bimanamara/WaterDSlytics/Graph Design/aki.png

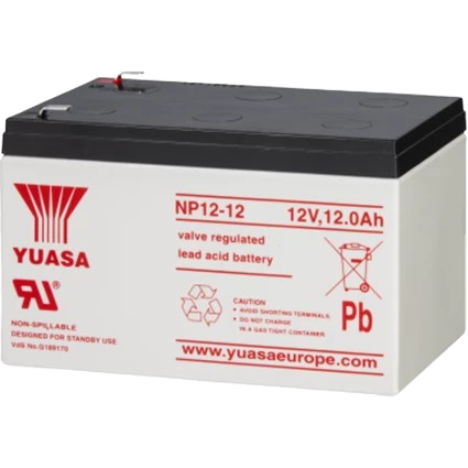
Graph Design/aki.png
