bimanamara/WaterDSlytics/Graph Design/LITHIUM ION.png

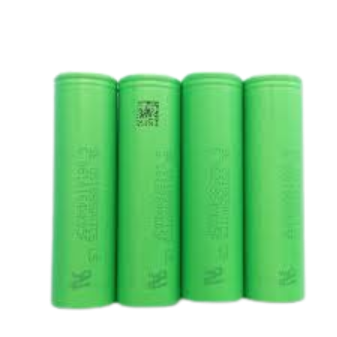
Graph Design/LITHIUM ION.png
