bimanamara/WaterDSlytics/Banner Proyek.pdf

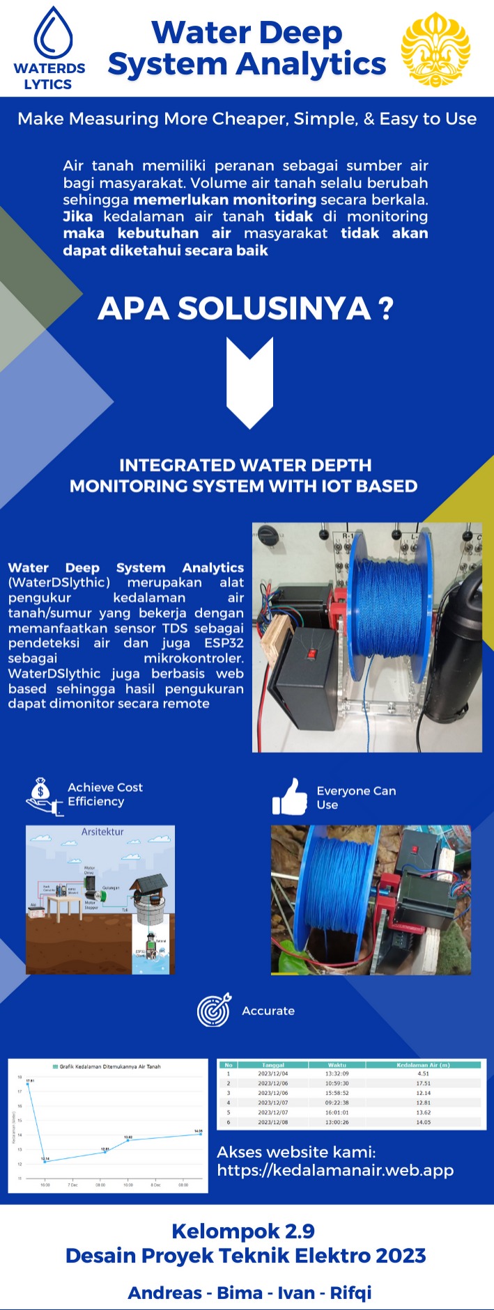
[picture p46: page 1]
