bimanamara/WaterDSlytics/Graph Design/BOTOL.png

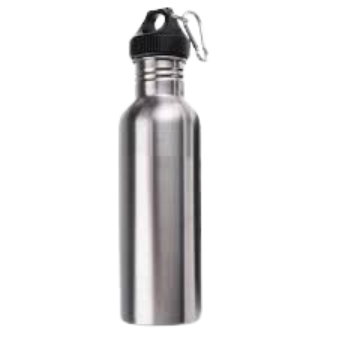
Graph Design/BOTOL.png
