bimanamara/WaterDSlytics/Graph Design/BUCK CONVERTER.png

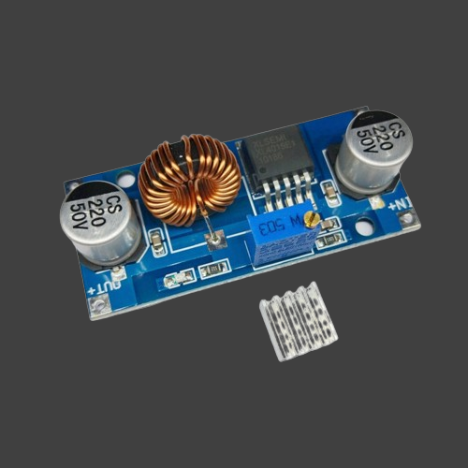
Graph Design/BUCK CONVERTER.png
