bimanamara/WaterDSlytics/Graph Design/DRIVER MOTOR STEPPER TB6600.png

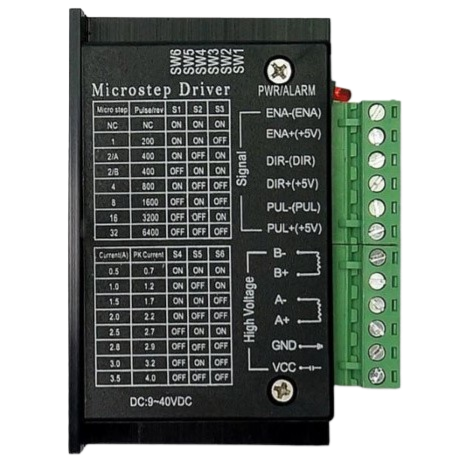
Graph Design/DRIVER MOTOR STEPPER TB6600.png
