bimanamara/WaterDSlytics/Graph Design/ESP32.png

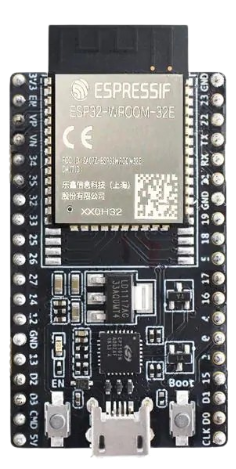
Graph Design/ESP32.png
