bimanamara/WaterDSlytics/Graph Design/flat-design-box-die-cut-template/7930025.jpg

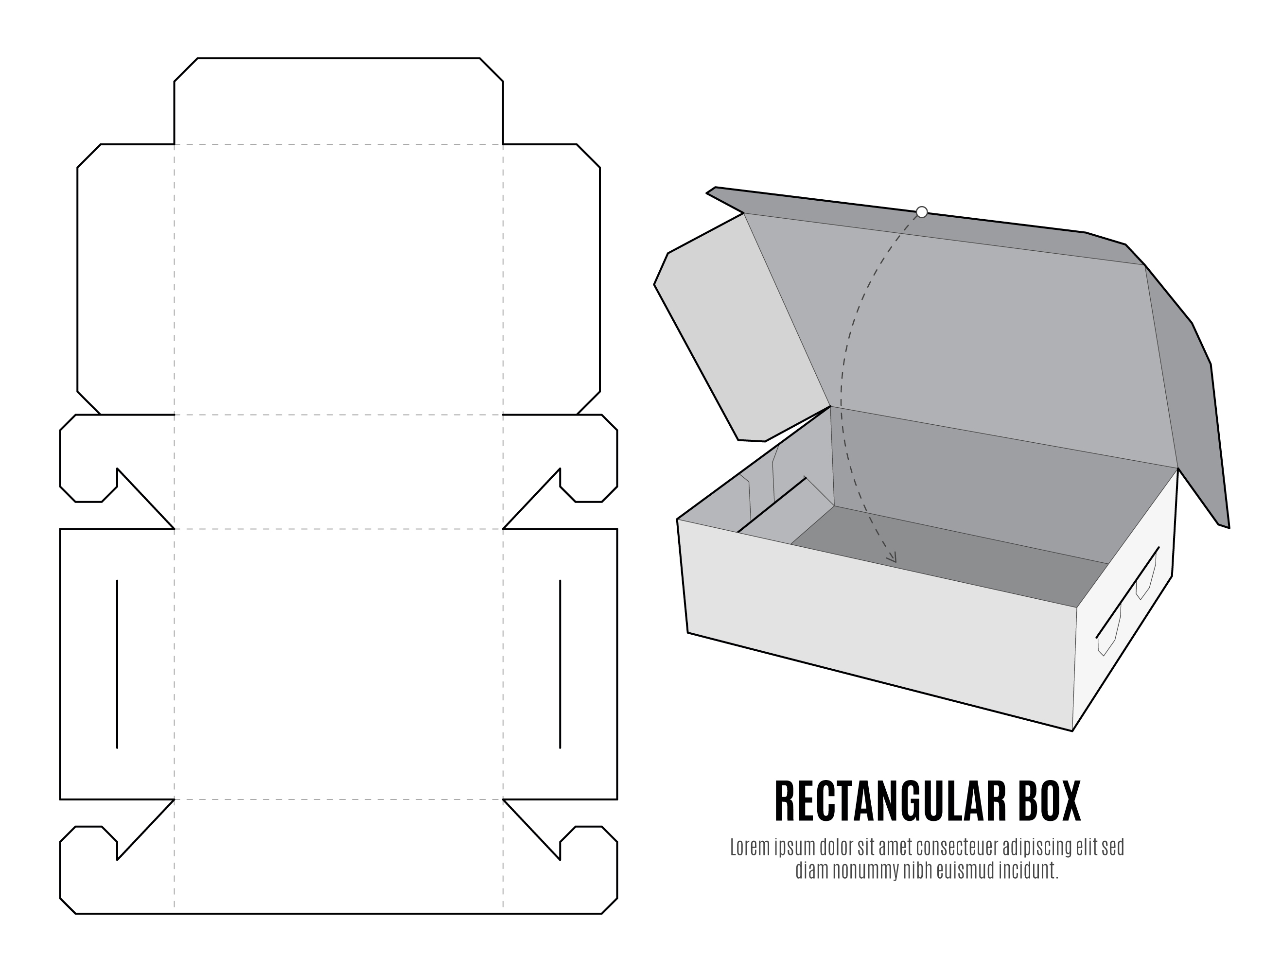
Graph Design/flat-design-box-die-cut-template/7930025.jpg
