bimanamara/WaterDSlytics/Graph Design/flat-design-world-habitat-day/4253801.jpg

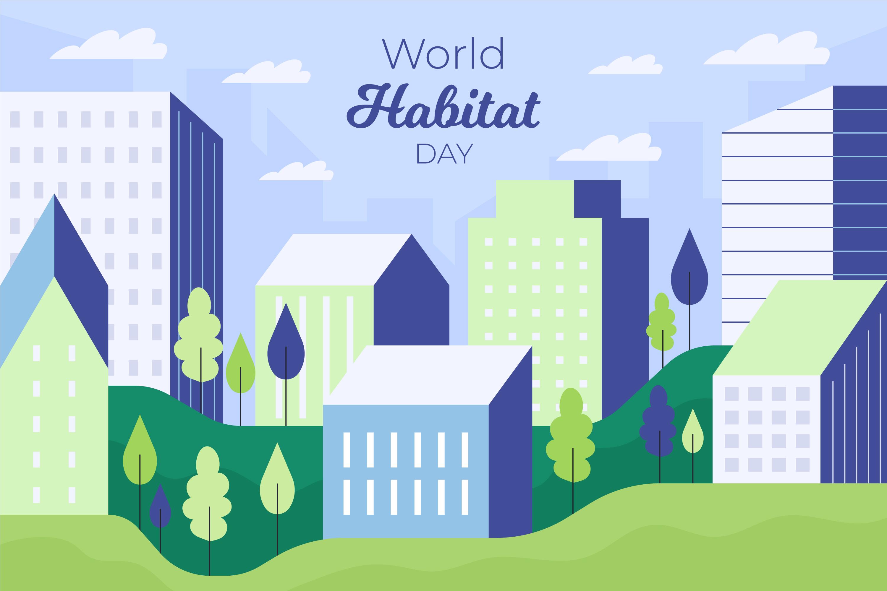
Graph Design/flat-design-world-habitat-day/4253801.jpg
