bimanamara/WaterDSlytics/Graph Design/gulungan 1.png

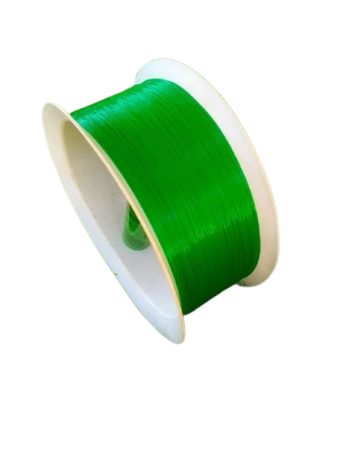
Graph Design/gulungan 1.png
