bimanamara/WaterDSlytics/Graph Design/meja kecil.png

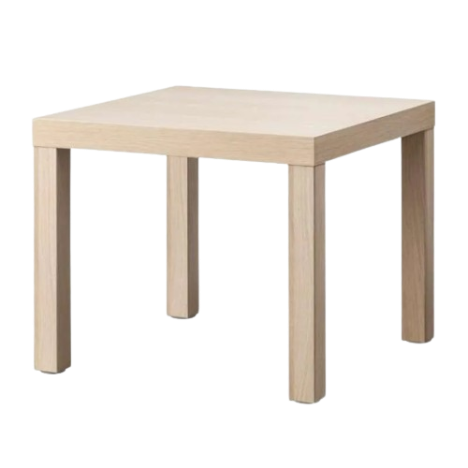
Graph Design/meja kecil.png
