bimanamara/WaterDSlytics/Graph Design/messageImage_1702189771055.jpg

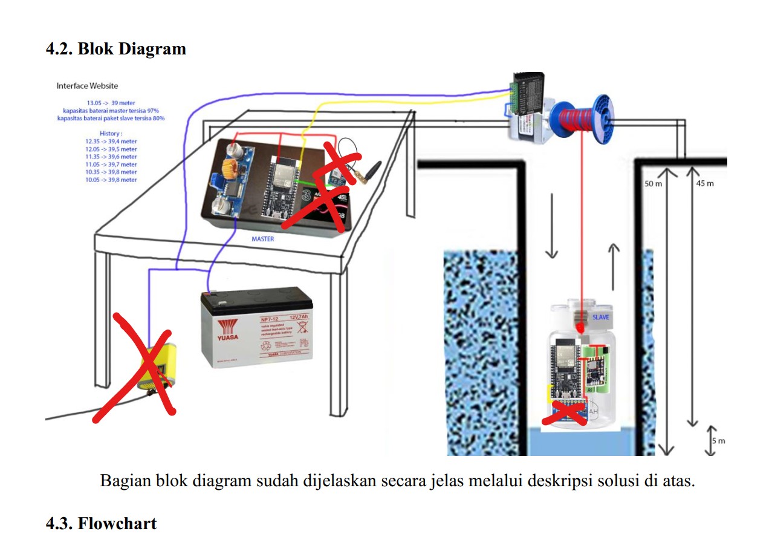
Graph Design/messageImage_1702189771055.jpg
