bimanamara/WaterDSlytics/Graph Design/MOTOR STEPPER.png

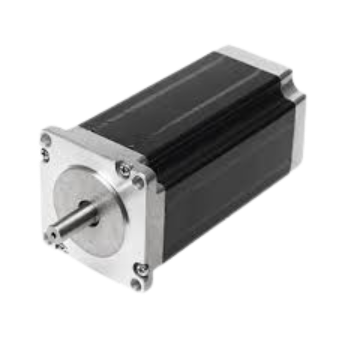
Graph Design/MOTOR STEPPER.png
