bimanamara/WaterDSlytics/Graph Design/sumur.png

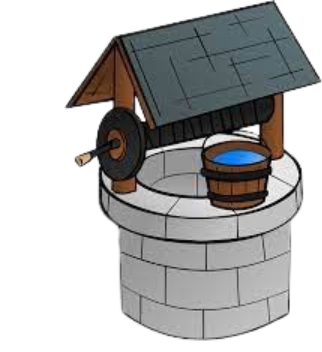
Graph Design/sumur.png
