bimanamara/WaterDSlytics/Graph Design/TDS asli.png

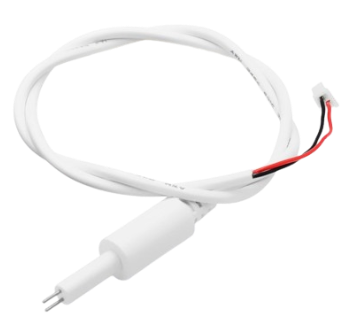
Graph Design/TDS asli.png
