bimanamara/WaterDSlytics/Kelompok 2.9_Rekap Biaya Terbaru.xlsx

LINK BUKTI LAMPIRAN REKAP TRANSAKSI : https://docs.google.com/document/d/1Jam1K2B390JuWFsyJVYhOXZ56DJ6v8_B9Y5BSTzgP9A/edit
Grup | Nomor | Item | Tanggal Pembelian | Bukti Pembayaran | Total | Jumlah | Pembeli
2023-09-02 | 1 | Kartu Perdana Tri 10.5 GB | 2023-11-09 | Tokopedia Invoice, Bukti Barang, Bukti Pengiriman Sampai Tujuan | Rp 26000 | 1 | Rifqi
2023-09-02 | 2 | Tumbler Japan Hook Termos Travel | 2023-11-09 | Tokopedia Invoice, Bukti Barang, Bukti Pengiriman Sampai Tujuan | Rp 35300 | 1
2023-09-02 | 3 | PCB Dot Matrix Thrus hole Double | 2023-11-09 | Tokopedia Invoice, Bukti Barang, Bukti Pengiriman Sampai Tujuan | Rp 5800 | 2
2023-09-02 | 4 | ESP32 WIFI Blootooth+Micro USB | 2023-11-09 | Tokopedia Invoice, Bukti Barang, Bukti Pengiriman Sampai Tujuan | Rp 137000 | 2
2023-09-02 | 5 | Isolasi Kabel Listrik | 2023-11-09 | Tokopedia Invoice, Bukti Barang, Bukti Pengiriman Sampai Tujuan | Rp 4100 | 1
2023-09-02 | 6 | Tempat Baterai | 2023-11-09 | Tokopedia Invoice, Bukti Barang, Bukti Pengiriman Sampai Tujuan | Rp 5600 | 1
2023-09-02 | 7 | Box Elektronik X4 | 2023-11-09 | Tokopedia Invoice, Bukti Barang, Bukti Pengiriman Sampai Tujuan | Rp 9500 | 1
2023-09-02 | 8 | Pin header Male | 2023-11-09 | Tokopedia Invoice, Bukti Barang, Bukti Pengiriman Sampai Tujuan | Rp 3200 | 4
2023-09-02 | 9 | Pin header Female | 2023-11-09 | Tokopedia Invoice, Bukti Barang, Bukti Pengiriman Sampai Tujuan | Rp 5400 | 6
2023-09-02 | 10 | PCB Dot Matrix Thrus hole Double 3x7 | 2023-11-09 | Tokopedia Invoice, Bukti Barang, Bukti Pengiriman Sampai Tujuan | Rp 8000 | 4
2023-09-02 | 11 | Timah Solder 10 meter | 2023-11-09 | Tokopedia Invoice, Bukti Barang, Bukti Pengiriman Sampai Tujuan | Rp 21500 | 1
2023-09-02 | 12 | Kabel AWG24 Biru | 2023-11-09 | Tokopedia Invoice, Bukti Barang, Bukti Pengiriman Sampai Tujuan | Rp 4125 | 3
2023-09-02 | 13 | Terminal Blok 3 Pin | 2023-11-09 | Tokopedia Invoice, Bukti Barang, Bukti Pengiriman Sampai Tujuan | Rp 3500 | 4
2023-09-02 | 14 | Terminal Blok 2 Pin | 2023-11-09 | Tokopedia Invoice, Bukti Barang, Bukti Pengiriman Sampai Tujuan | Rp 2792 | 4
2023-09-02 | 15 | Kabel AWG24 Merah | 2023-11-09 | Tokopedia Invoice, Bukti Barang, Bukti Pengiriman Sampai Tujuan | Rp 4125 | 3
2023-09-02 | 16 | Kabel 2x AWG18 | 2023-11-09 | Tokopedia Invoice, Bukti Barang, Bukti Pengiriman Sampai Tujuan | Rp 15500 | 2
2023-09-02 | 17 | Kabell AWG24 Hitam | 2023-11-09 | Tokopedia Invoice, Bukti Barang, Bukti Pengiriman Sampai Tujuan | Rp 4125 | 3
2023-09-02 | 18 | Stand Dudukan Roll Filamen | 2023-10-22 | Tokopedia Invoice, Bukti Barang, Bukti Pengiriman Sampai Tujuan | Rp 46437 | 1
2023-09-02 | 19 | Tali Tambang 2mm | 2023-10-22 | Tokopedia Invoice | Rp 24303 | 1
2023-09-02 | 20 | Sim800l V2 V.2 V2.0 5V GSM GPRS module antena antenna micro sim card | 2023-11-01 | Tokopedia Invoice, ATM BNI, Bukti Barang, Bukti Pengiriman Sampai Tujuan | Rp 95100 | 1 | Bima
2023-09-02 | 21 | DFRobot : Analog TDS Sensor/Meter for Arduino | 2023-11-04 | Tokopedia Invoice, ATM BNI, Bukti Barang, Bukti Pengiriman Sampai Tujuan | Rp 218400 | 1
2023-09-02 | 22 | 3D Print Jasa dan Bahan | 2023-11-14 | Cash, Bukti Desain, Bukti Barang | Rp 350000 | 1
2023-09-02 | 23 | TB6600 Motor Driver, NEMA 17HS4401 Motor Stepper, Charge&Discharge Boost Converter Module, Bracket NEMA17 | 2023-10-06 | Tokopedia Invoice, Bukti Pengiriman, Gopay, Bukti Barang | Rp 184300 | 1 | Andreas
2023-09-02 | 24 | 2 Buah Baterai Panasonic 18650 | 2023-10-22 | Tokopedia Invoice, Bukti Pengiriman, Gopay, Bukti Barang | Rp 121900 | 1
2023-09-02 | 25 | Aki Kering Yuasa 12V 7Ah NP7-12 | 2023-11-09 | Tokopedia Invoice, Bukti Pengiriman, Gopay, Bukti Barang | Rp 240000 | 1
