bimanamara/WaterDSlytics/Graph Design/PDF/Artboard 1.pdf

# Arsitektur

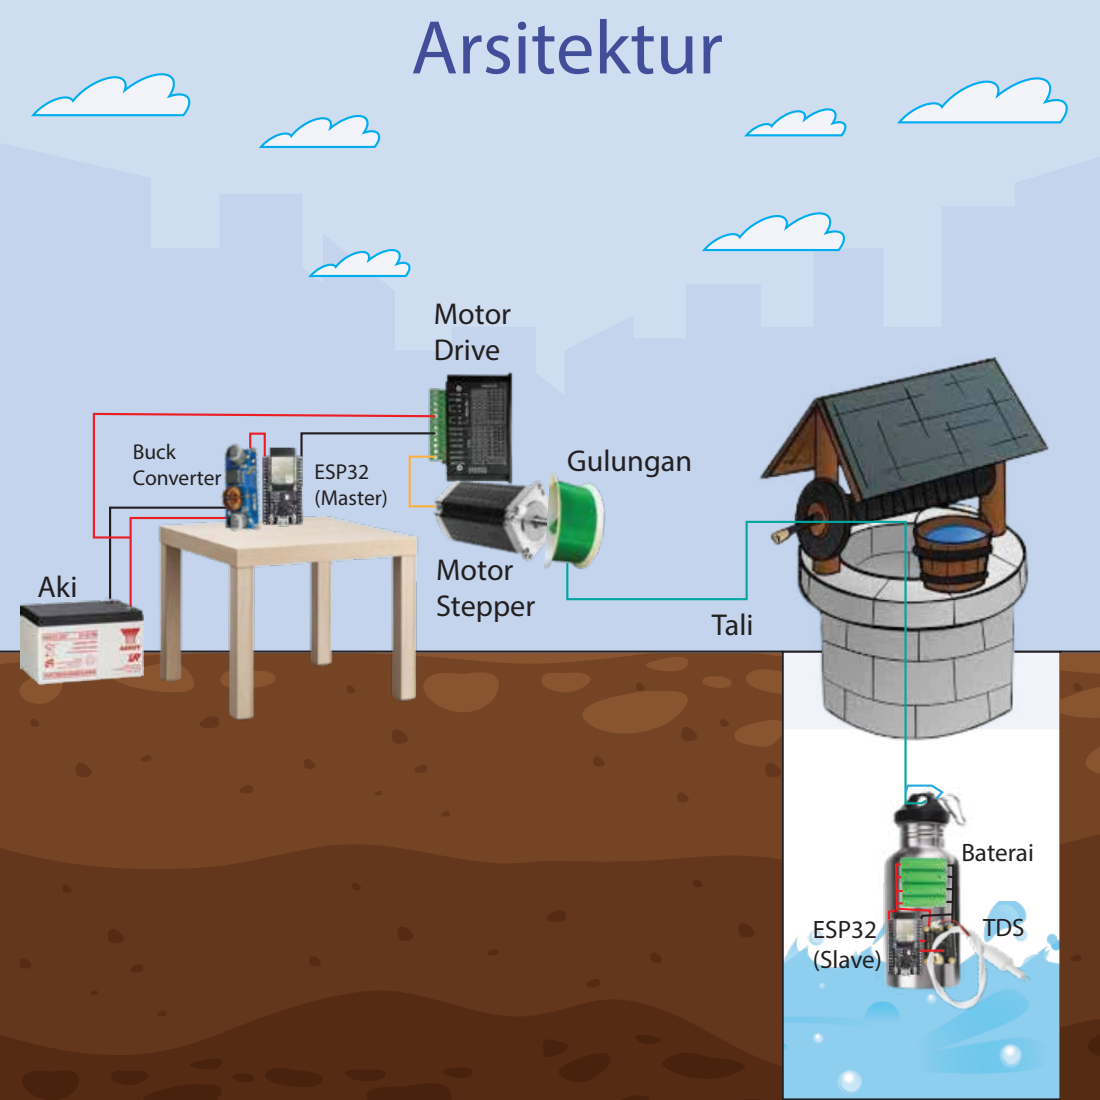
[picture p59: page 1]
Baterai; ESP32; TDS; (Slave); Aki; Motor Drive; Motor Stepper; Gulungan; Tali; ESP32 (Master); Buck Converter
